codemonkeyrawks/Rover-BOT/readme.md

## Rover-BOT - 

<h4>
Master Branch: 
<a href="https://travis-ci.org/codemonkeyrawks/Rover-BOT/branches">
</h4>

<table>
<tr>
<td>

</td>
</tr>
<tr>
<td>
<p>Rover-BOT in Action</p>
</td>
</tr>
</table>

#### Folder Structure:

    Main Project:
    /Parallax             - Used for Testing Only (Basic Stamp Software)
    /Program Code         - Contains the Basic Stamp Code (Bot & Controller) & C Code - Arm
    /Project Powerpoint   - Contains a Slideshow and Manual
    /Project Report       - Contains the Manual, Schematic, Flowchart and Instruction Guide
    .Project Requirements - Requirements in Our Project
    licence.txt           - GPL Licence
    readme.md             - Getting Started Guide
    
    Testing:
    .travis.yml - Used for Testing Only
    .gitlab-ci.yml - Used for Testing Only

#### Building:
```shell
Open Terminal and Run:
# sudo apt-get install git
# git clone https://github.com/codemonkeyrawks/Rover-BOT.git
# cd Rover-BOT => Examine Project Over
```
