codemonkeyrawks/Rover-BOT/Project Powerpoint/Presentation.pptx

## Rover-bot

By: Brian & Charlie

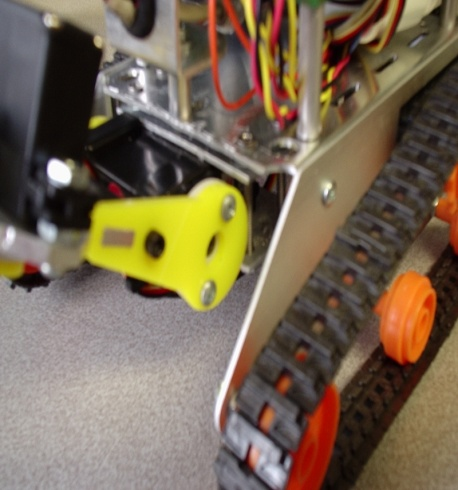
[picture p35: figure]
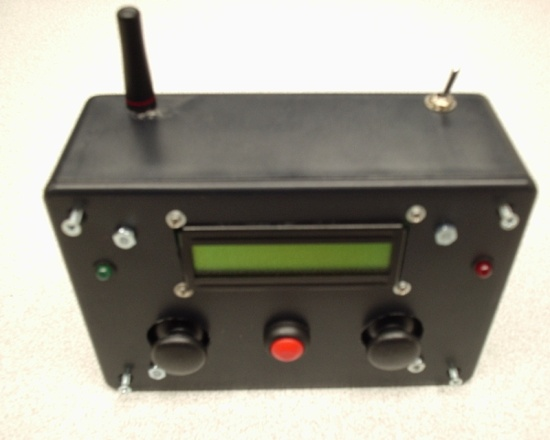
[picture p36: figure]
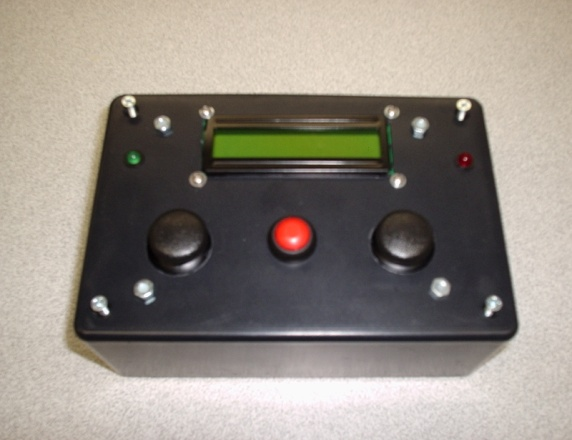
[picture p37: figure]
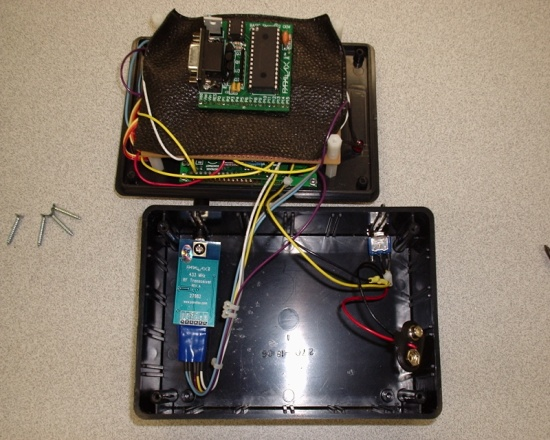
[picture p38: figure]
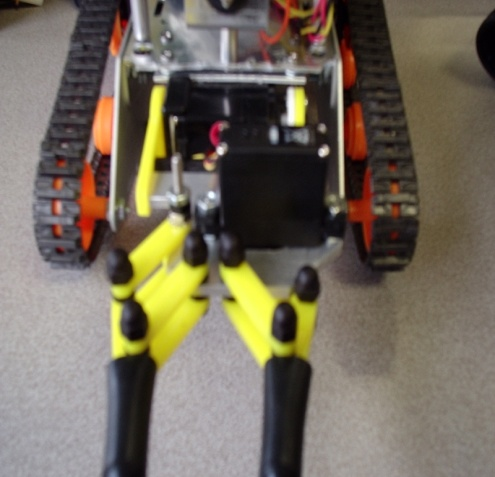
[picture p39: figure]
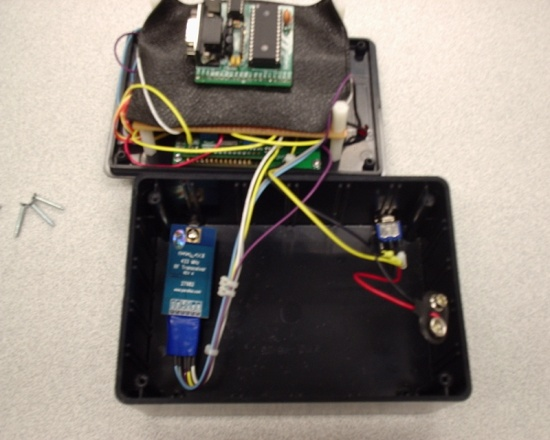
[picture p40: figure]
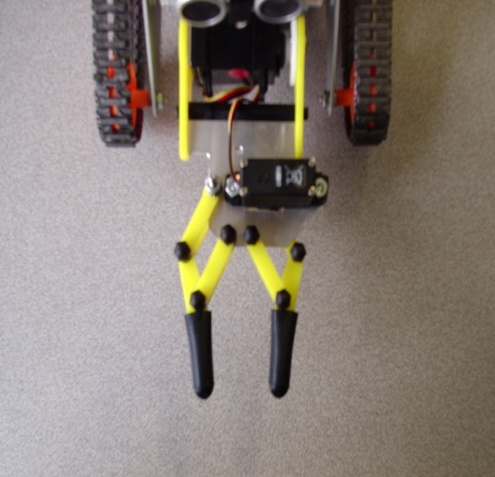
[picture p41: figure]
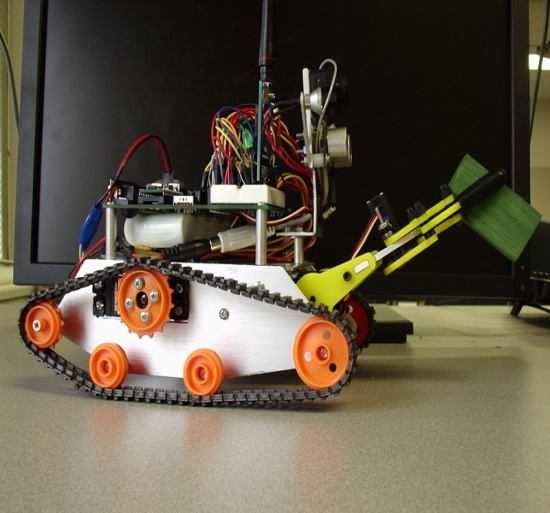
[picture p42: figure]
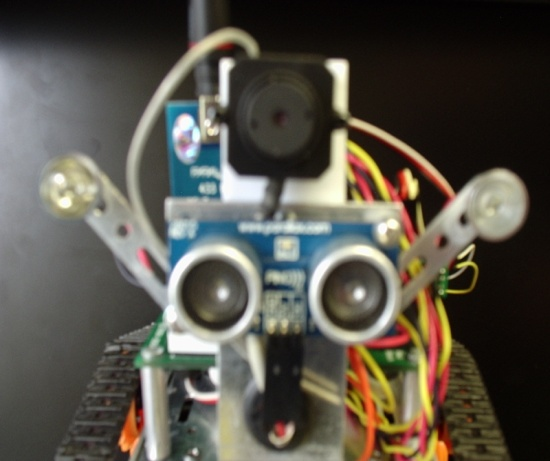
[picture p43: figure]
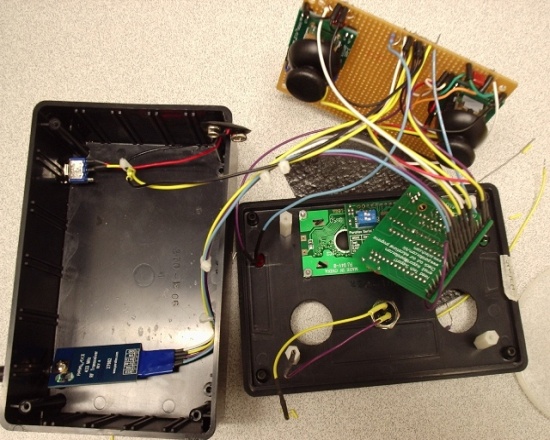
[picture p44: figure]

## Project Objective

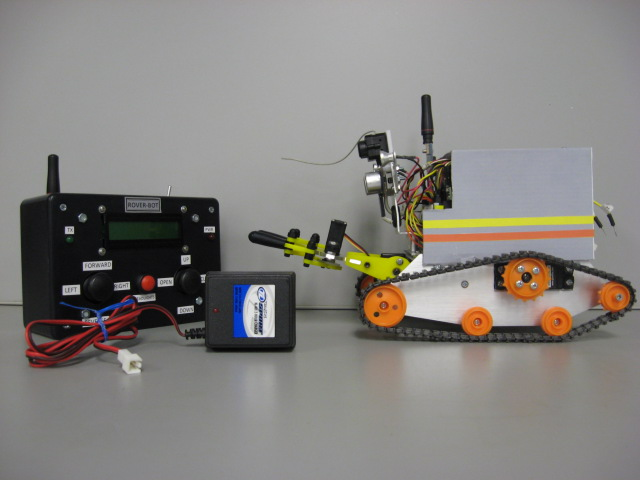
[picture p45: figure]

The project was to build a wireless remote control vehicle that has the capability of moving objects to different locations in the room and drop them into a designated place.

## Block Diagram

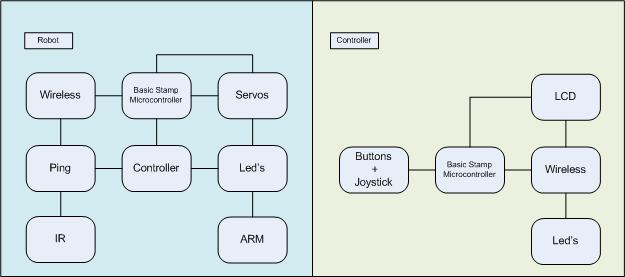
[picture p46: figure]

## Overview of Circuitry


## Operation & Flowchart

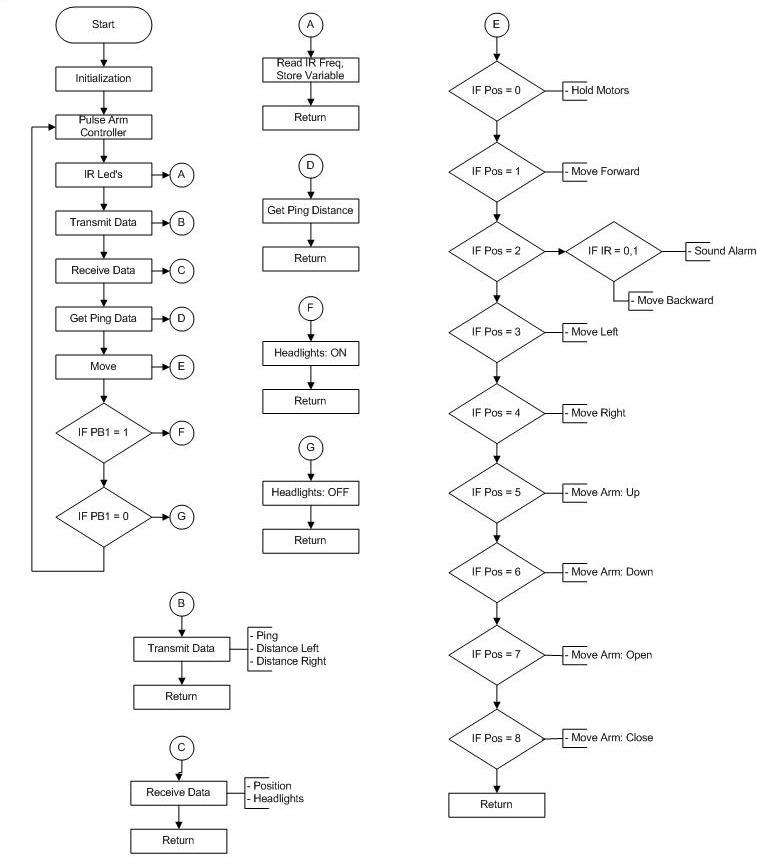
[picture p47: figure]

## Slide 6

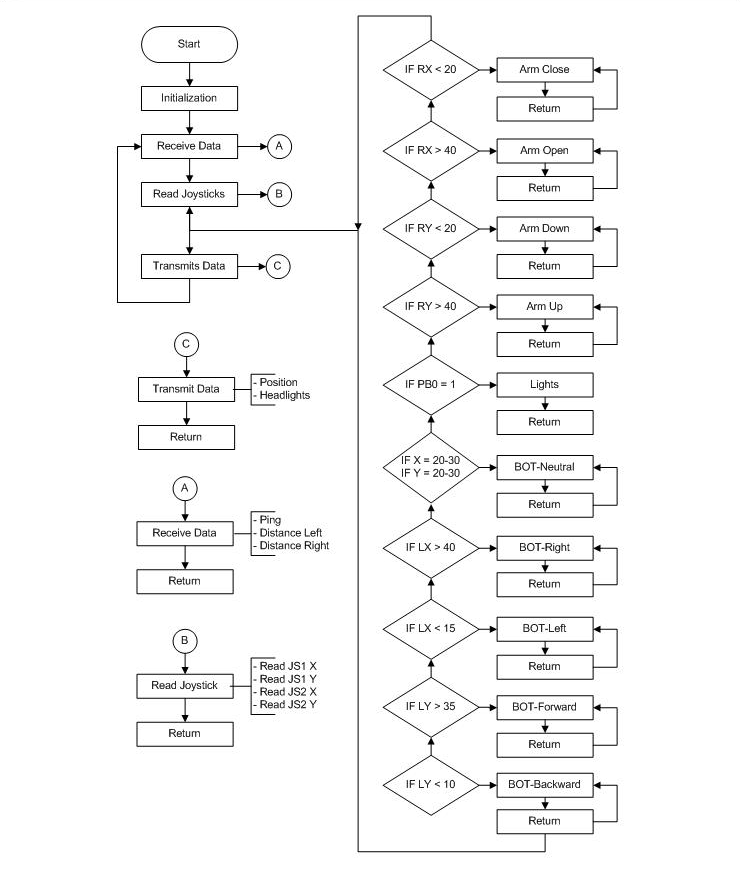
[picture p48: figure]

## Issues Encountered

Robot:

Two Way Communication

Arm:

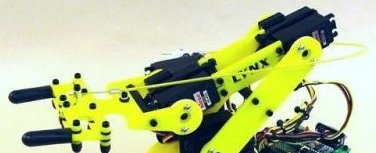
[picture p49: figure]

Original Design

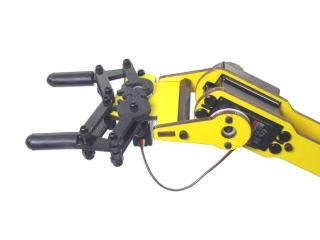
[picture p50: figure]

Modified Version

Unreliable Operation
Unstable Servo Pulse

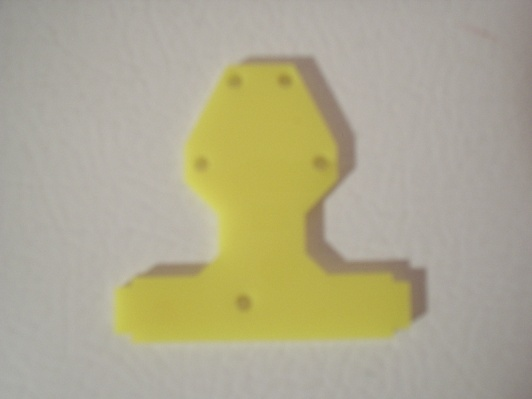
[picture p51: figure]

Original Plate

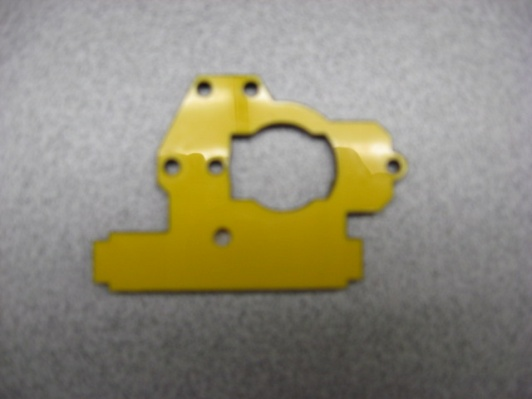
[picture p52: figure]

Needed Plate

Controller:

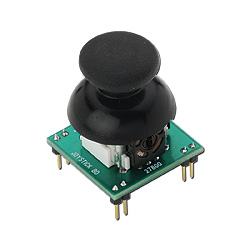
[picture p53: figure]

1. XY Comparison Values
2. RC Time-Constant vs. Variable

## Problems Overcome

1. Analyzed Code Section
2. Attempted Several Code Modifications
3. Found out it was:
Order of Operation

Robot:

Original Design

Arm:

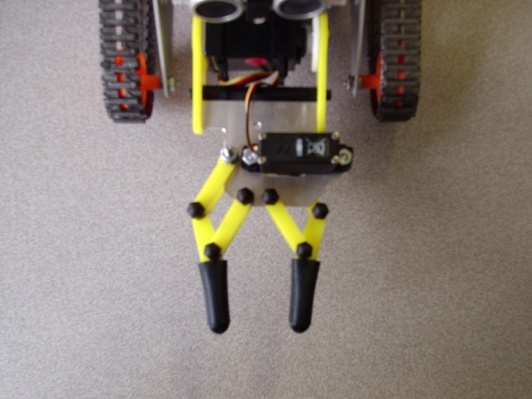
[picture p54: figure]

Our Version

Used a Micro Servo and
Microprocessor

Original Plate

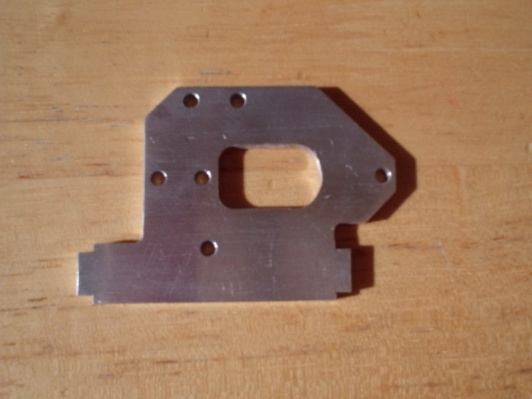
[picture p55: figure]

Plate Designed

Controller:

1. Use 2 Values per Axis
2. Sending less Data across Wi-Fi

## Additional Add-ons

Camera

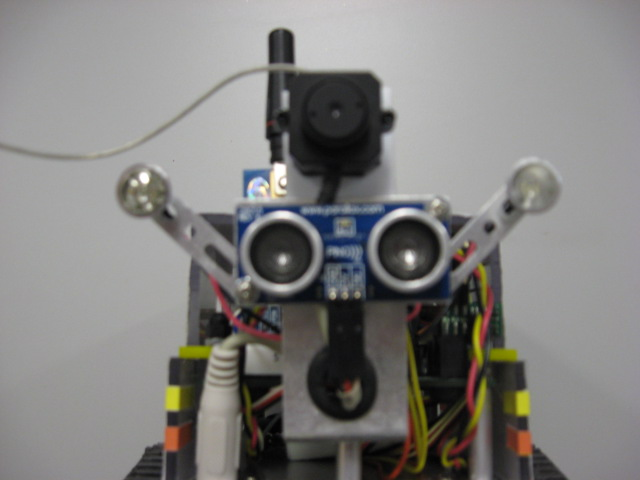
[picture p56: figure]

## Questions
